ErkhovArtem/stm32-dynamixel-adapter/hardware/bom.csv

Designators | Quantity | Value | Voltage Rating | Device | Footprint | Manufacturer | Manufacturer Part | Supplier | Supplier Part | Notes
C1, C3 | 2 | 100nF |  | C0805C104K1RACAUTO | C0805 | KEMET(基美) | C0805C104K1RACAUTO | LCSC | C141125
C2 | 1 | 100uF |  | 25YXF100MFFC6.3X11 | CAP-TH_BD6.3-P2.50-D1.0-FD | rubycon(红宝石) | 25YXF100MFFC6.3X11 | LCSC | C125770
C4 | 1 | 10uF |  | 50YXF10MFFC5X11 | CAP-TH_BD5.0-P2.00-D0.8-FD | rubycon(红宝石) | 50YXF10MFFC5X11 | LCSC | C216202
C5 | 1 | 10uF | 10V | C0805X106K010T | C0805 | IHHEC(禾伸堂) | C0805X106K010T | LCSC | C340314
C6 | 1 | 100nF |  | C0805C104K1RACAUTO | C0805 | KEMET(基美) | C0805C104K1RACAUTO | LCSC
CN1 | 1 |  |  | XT30UPB-M | CONN-TH_XT30UPB-M | AMASS(艾迈斯) | XT30UPB-M | LCSC | C428721
D1 | 1 |  |  | USBLC6-2SC6 | SOT-23-6_L2.9-W1.6-P0.95-LS2.8-BR | ST(意法半导体) | USBLC6-2SC6 | LCSC | C7519
D2, D3 | 2 |  |  | 1N4148W-E3-18 | SOD-123_L2.7-W1.6-LS3.7-FD | VISHAY(威世) | 1N4148W-E3-18 | LCSC | C191428
H1, H2, H4, H5 | 4 |  |  | HDR-M_2.54_1x2P | HDR-TH_2P-P2.54-V-M-1 |  |  |  | C124375
H3 | 1 |  |  | HDR-M_2.54_1x4P | HDR-TH_4P-P2.54-V-M |  |  |  | C492403
H6, H7 | 2 |  |  | HDR-M_2.54_1x20P | HDR-TH_20P-P2.54-V-M-1 |  |  |  | C50981 | Library specifies a male header; assembled board photo uses female sockets. Choose the connector gender required for the STM32 module.
Q1, Q2 | 2 |  |  | AO3400A_N | SOT-23-3_L2.9-W1.3-P1.90-LS2.4-BR |  |  |  | C700953
R1, R2 | 2 | 22R |  | Res_0603 | R0805_NEW |  |  |  |  | Library device is named Res_0603; actual PCB footprint is R0805_NEW. Use the PCB footprint for package selection.
R3, R4, R5, R7 | 4 | 10kΩ |  | TR0805B10K0P0525Z | R0805 | EVER OHMS(天二科技) | TR0805B10K0P0525Z | LCSC | C188360
R6 | 1 | 20kΩ |  | PTFR0805B20K0N9 | R0805 | RESI(开步睿思） | PTFR0805B20K0N9 | LCSC | C328439
R8 | 1 | 120Ω |  | AECR0805F120RK9 | R0805 | RESI(开步睿思） | AECR0805F120RK9 | LCSC | C352273
R9, R11 | 2 | 220R |  | Res_0603 | R0805_NEW |  |  |  |  | Library device is named Res_0603; actual PCB footprint is R0805_NEW. Use the PCB footprint for package selection.
R10, R12 | 2 | 10K |  | Res_0603 | R0805_NEW |  |  |  |  | Library device is named Res_0603; actual PCB footprint is R0805_NEW. Use the PCB footprint for package selection.
U1 | 1 |  |  | MAX485EN | DIP-8_L10.0-W6.5-P2.54-LS7.6-BL | HTC | MAX485EN | LCSC | C481665
USB1 | 1 |  |  | 916-352A1024Y10210 | USB-A-TH_USB-A-F-1 | 精拓金 | 916-352A1024Y10210 | LCSC | C109357
