ErkhovArtem/stm32-dynamixel-adapter/firmware/PTZ_X30.ioc

Mcu.UserName=STM32F411CEUx
PA1.Signal=GPIO_Output
PA10.Signal=USART1_RX
PA11.Signal=USB_OTG_FS_DM
PA12.Signal=USB_OTG_FS_DP
PA13.Signal=SYS_JTMS-SWDIO
PA14.Signal=SYS_JTCK-SWCLK
PA2.Signal=GPIO_Output
PA8.Signal=GPIO_Output
PA9.Signal=USART1_TX
PC13-ANTI_TAMP.Signal=GPIO_Output
